sim-red-line/single-stage-vision-cartpole/docs/ko/README.md

[English README](../../README.md) | **한국어**

# 한국어 문서

기본 문서는 영어이며, 아래에는 기존 한국어 원문을 별도로 보존했습니다. 수치, 명령, 파일 경로와 실험 판정은 번역 전 원문을 유지합니다.

- [프로젝트 README](../../README.ko.md)
- [240 mm/s 확대 시험 검토 및 점검 기록](capture240_review.md)
- [스윙업과 균형 제어](control_algorithm.md)
- [자동 스윙업 후 15초 수직 기록 — 제어 효과 미확인](hold15_success_20261031.md)
- [위치 쏠림 비교와 각도 기준 보정](position_drift_review_20261101.md)
- [축 수정 후 기준 재시험](shaft_corrected_retest_20261031.md)
- [고정 PID 스윙업 게인 비교](swing_gain_comparison_20261031.md)
- [자동 스윙업 후 5초 균형 유지 확인](swing_up_success_20261031.md)
- [비전 처리 파이프라인](vision_pipeline.md)

다음 문서는 처음부터 영어로 작성되어 기본 경로에 그대로 있습니다.

- [System architecture](../architecture.md)
- [Balance prediction validation](../balance_prediction_validation.md)
- [Firmware analysis](../firmware_analysis.md)
- [Hardware validation](../hardware_validation.md)
- [Rehoming record](../rehome_20261031.md)
- [Swing-up validation](../swing_up_validation.md)
