sim-red-line/single-stage-vision-cartpole/docs/rehome_20261031.md

# Full rehome — 2026-10-31

The operator requested a fresh full home. Before motion, the firmware reported
282.713 mm while the camera reported approximately 108.6 mm. The motor and its
target were both stopped. The cause of that discrepancy was not established.

The existing `cartpole-safe-8` full-home routine sought the left switch, backed
off, sought the right switch, and returned to the center at its existing
40 mm/s seek and 20 mm/s back-off speeds. No firmware, rail coordinate profile,
or HSV calibration was changed.

The host monitor ended on a brief tracking loss near the right end. The
firmware independently completed its return to center. A subsequent 20-sample
verification confirmed `homed=true`, `home_state=none`, no firmware fault or
ESTOP, and actual/target velocities of exactly zero throughout:

- Measured travel: **513.113 mm**.
- Stopped motor position: **256.538 mm**.
- Median camera position among 16 valid samples: **255.875 mm**.
- Pi power remained clean; the watchdog remained healthy.

Color tracking was intermittent after homing: 16/20 samples were valid, with
`IDLE` and `CALIBRATION_REQUIRED` both observed. Background brightness was
43–44, compared with profile baseline 88. No subsequent swing-up was started.
The operator was asked to establish steady room lighting before further motion.

The initial monitor result and the separate final verification are preserved in
`experiments/maintenance/rehome-20261031T073931Z.json` on the Pi. A copy is in
the PC's `pi-review-20261031` artifact directory, together with `home-stop.jpg`.
The partial recording is retained as
`experiments/videos/rehome-20261031T073931Z.avi` on the Pi.

## Homing abort behavior

In the currently installed firmware, ordinary `STOP` zeros the target but does
**not** leave the homing state machine; the next update can restore the homing
velocity. `ESTOP` is required to abort an active home. The temporary supervised
home helper was corrected to use `ESTOP` on an unsuccessful exit while homing
remains active. The successful final centered state was not emergency-stopped
or unhomed. No firmware change was flashed.
