sim-red-line/single-stage-vision-cartpole/experiments/logs/20261030T154400Z-1a0b40c7.csv

experiment_id | elapsed_s | timestamp_monotonic_s | theta_rad | omega_rad_s | cart_position_mm | cart_velocity_mm_s | target_angle_rad | requested_velocity_mm_s | limited_velocity_mm_s | angle_p | angle_i | angle_d | position_p | position_i | position_d | output_saturated | tracking_valid | tracking_status | tracking_confidence | processing_ms | fps | control_latency_ms | motor_position_mm | motor_velocity_mm_s | safety_state
20261030T154400Z-1a0b40c7 | 0.006761851998817292 | 9592.134708347 | -0.002691111052196055 | -0.004869940853147103 | 255.45188817788923 | 1.3194709869386325 | 7.061761030253141e-06 | -0.6248806344200643 | -0.6248806344200643 | 59.35980189097878 | 0.0 | 0.0 | 7.061761030253141e-06 | 0.0 | 0.0 | False | True | ok | 0.8294235374839392 | 4.085501001100056 | 30.04754931825734 | 37.6746309993905 | 255.9 | 0.0 | RUNNING
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
