sim-red-line/single-stage-vision-cartpole/experiments/logs/20261030T155423Z-29d98ef0.csv

experiment_id | elapsed_s | timestamp_monotonic_s | theta_rad | omega_rad_s | cart_position_mm | cart_velocity_mm_s | target_angle_rad | requested_velocity_mm_s | limited_velocity_mm_s | angle_p | angle_i | angle_d | position_p | position_i | position_d | output_saturated | tracking_valid | tracking_status | tracking_confidence | processing_ms | fps | control_latency_ms | motor_position_mm | motor_velocity_mm_s | safety_state
20261030T155423Z-29d98ef0 | 0.006832979999671807 | 10215.157145779 | 0.00364630324019608 | -0.016246435098426895 | 270.479204361624 | 3.9528297378374377 | -0.0001086485735845046 | 0.8075465833189879 | 0.8075465833189879 | -82.60893990317287 | -0.0 | 0.0 | -0.0001086485735845046 | -0.0 | 0.0 | False | True | ok | 0.8796325057960412 | 5.218498999965959 | 30.473310275234105 | 13.966385999083286 | 271.275 | 0.0 | RUNNING
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
