sim-red-line/single-stage-vision-cartpole/experiments/logs/20261030T160830Z-a79b83b6.csv

experiment_id | elapsed_s | timestamp_monotonic_s | theta_rad | omega_rad_s | cart_position_mm | cart_velocity_mm_s | target_angle_rad | requested_velocity_mm_s | limited_velocity_mm_s | angle_p | angle_i | angle_d | position_p | position_i | position_d | output_saturated | tracking_valid | tracking_status | tracking_confidence | processing_ms | fps | control_latency_ms | motor_position_mm | motor_velocity_mm_s | safety_state
20261030T160830Z-a79b83b6 | 0.012223493000419694 | 11061.276068865 | 0.04483214197887108 | -0.05551961691387021 | 188.43052857621902 | -0.3445245605664575 | 0.0005288385755818618 | 9.154014324194126 | 9.154014324194126 | -974.6726748723628 | -0.0 | 99.27348379384748 | 0.0005231262299631138 | 0.0 | 5.712345618747943e-06 | False | True | ok | 0.85351499786338 | 3.4786599990184186 | 29.90306207920525 | 39.19173400026921 | 190.238 | 0.0 | RUNNING
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
