sim-red-line/single-stage-vision-cartpole/experiments/logs/20261031T030904Z-60fe1378.csv

experiment_id | elapsed_s | timestamp_monotonic_s | theta_rad | omega_rad_s | cart_position_mm | cart_velocity_mm_s | target_angle_rad | requested_velocity_mm_s | limited_velocity_mm_s | angle_p | angle_i | angle_d | position_p | position_i | position_d | output_saturated | tracking_valid | tracking_status | tracking_confidence | processing_ms | fps | control_latency_ms | motor_position_mm | motor_velocity_mm_s | safety_state
20261031T030904Z-60fe1378 | 0.06602687500003412 | 1441.40026224 | -3.1408468535891654 | -0.044734704135527124 | 255.1919876422578 | -1.7676855502650048 | 0.0 | 0.0 | 0.0 | 0.0 | 0.0 | 0.0 | 0.0 | 0.0 | 0.0 | False | True | ok | 0.8762471990470034 | 3.6396129999047844 | 29.89095692301485 | 98.70014600005561 | 256.388 | 0.0 | RUNNING
20261031T030904Z-60fe1378 | 0.07528304499987826 | 1441.40951841 | -3.1408468535891654 | -0.044734704135527124 | 255.1919876422578 | -1.7676855502650048 | 0.0 | 0.5886288981100728 | 0.5886288981100728 | 0.0 | 0.0 | 0.0 | 0.0 | 0.0 | 0.0 | False | True | ok | 0.8762471990470034 | 3.6396129999047844 | 29.89095692301485 | 107.95631599989974 | 256.388 | 0.0 | RUNNING
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
