sim-red-line/single-stage-vision-cartpole/experiments/logs/20261031T084851Z-1f73ccf4.csv

experiment_id | elapsed_s | timestamp_monotonic_s | theta_rad | omega_rad_s | cart_position_mm | cart_velocity_mm_s | target_angle_rad | requested_velocity_mm_s | limited_velocity_mm_s | angle_p | angle_i | angle_d | position_p | position_i | position_d | output_saturated | tracking_valid | tracking_status | tracking_confidence | processing_ms | fps | control_latency_ms | motor_position_mm | motor_velocity_mm_s | safety_state
20261031T084851Z-1f73ccf4 | 0.011045685998396948 | 21827.908326143 | -3.137462368463714 | -0.042201483140111594 | 245.1830969766399 | -5.888103743073773 | 0.0 | 0.0 | 0.0 | 0.0 | 0.0 | 0.0 | 0.0 | 0.0 | 0.0 | False | True | ok | 0.8290232923106002 | 5.712556001526536 | 30.106143074156527 | 17.133908997493563 | 244.313 | 0.0 | RUNNING
20261031T084851Z-1f73ccf4 | 0.021041241998318583 | 21827.918321699 | -3.137462368463714 | -0.042201483140111594 | 245.1830969766399 | -5.888103743073773 | 0.0 | 2.533465636331058 | 2.533465636331058 | 0.0 | 0.0 | 0.0 | 0.0 | 0.0 | 0.0 | False | True | ok | 0.8290232923106002 | 5.712556001526536 | 30.106143074156527 | 27.129464997415198 | 244.313 | 0.0 | RUNNING
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
