sim-red-line/single-stage-vision-cartpole/experiments/logs/20261031T085149Z-ea593eea.csv

experiment_id | elapsed_s | timestamp_monotonic_s | theta_rad | omega_rad_s | cart_position_mm | cart_velocity_mm_s | target_angle_rad | requested_velocity_mm_s | limited_velocity_mm_s | angle_p | angle_i | angle_d | position_p | position_i | position_d | output_saturated | tracking_valid | tracking_status | tracking_confidence | processing_ms | fps | control_latency_ms | motor_position_mm | motor_velocity_mm_s | safety_state
20261031T085149Z-ea593eea | 0.00603353699989384 | 22006.339933809 | -3.136370092698957 | 0.024872514233208194 | 245.36008764220165 | 0.39830252382624654 | 0.0 | 0.0 | 0.0 | 0.0 | 0.0 | 0.0 | 0.0 | 0.0 | 0.0 | False | True | ok | 0.8442340913751955 | 3.7091109988978133 | 30.098670875741465 | 29.554851997090736 | 244.313 | 0.0 | RUNNING
20261031T085149Z-ea593eea | 0.016029426002205582 | 22006.349929698 | -3.137106549186889 | -0.009087550378295069 | 245.6045349182682 | 5.581838436142349 | 0.0 | 2.176112762156806 | 2.176112762156806 | 0.0 | 0.0 | 0.0 | 0.0 | 0.0 | 0.0 | False | True | ok | 0.8610698262926675 | 3.103129998635268 | 30.34928250124408 | 8.073926001088694 | 244.313 | 0.0 | RUNNING
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
